HalcyonVector/TinySHM/docs/final_report/reference_folder/README.md

# Reference folder

These are the 15 references of the final report, in the same order and numbering as the paper.
All are from 2020 to 2026. Every DOI was checked against the publisher record (OpenAlex / publisher page) on 28 Oct 2026.

Publisher mix: IEEE 6, Elsevier 4, Springer 3, SAGE 2.

How to get the PDFs: open each DOI link on the college network (MAHE has IEEE Xplore, ScienceDirect and SpringerLink access) and save the PDF into this folder with the file name given below. Papers marked **Open access** can be downloaded from anywhere.

| # | File name to save as | Reference | Publisher | DOI link | Free copy |
|---|---|---|---|---|---|
| 1 | 01_Gharehbaghi2022.pdf | Gharehbaghi et al., "A critical review on structural health monitoring: Definitions, methods, and perspectives", Arch. Comput. Methods Eng., 29(4), 2209-2235, 2022 | Springer | https://doi.org/10.1007/s11831-021-09665-9 | Accepted version: https://research.usq.edu.au/item/q6x1w |
| 2 | 02_Hou2021.pdf | Hou and Xia, "Review on the new development of vibration-based damage identification for civil engineering structures: 2010-2019", J. Sound Vib., 491, 115741, 2021 | Elsevier | https://doi.org/10.1016/j.jsv.2020.115741 | College network |
| 3 | 03_Avci2021.pdf | Avci et al., "A review of vibration-based damage detection in civil structures: From traditional methods to ML and DL applications", Mech. Syst. Signal Process., 147, 107077, 2021 | Elsevier | https://doi.org/10.1016/j.ymssp.2020.107077 | College network |
| 4 | 04_Flah2021.pdf | Flah et al., "Machine learning algorithms in civil structural health monitoring: A systematic review", Arch. Comput. Methods Eng., 28(4), 2621-2643, 2021 | Springer | https://doi.org/10.1007/s11831-020-09471-9 | College network |
| 5 | 05_Bao2021.pdf | Bao and Li, "Machine learning paradigm for structural health monitoring", Struct. Health Monit., 20(4), 1353-1372, 2021 | SAGE | https://doi.org/10.1177/1475921720972416 | College network |
| 6 | 06_Malekloo2022.pdf | Malekloo et al., "Machine learning and structural health monitoring overview with emerging technology and high-dimensional data source highlights", Struct. Health Monit., 21(4), 1906-1955, 2022 | SAGE | https://doi.org/10.1177/14759217211036880 | College network |
| 7 | 07_Zonzini2020.pdf | Zonzini et al., "Structural health monitoring and prognostic of industrial plants and civil structures: A sensor to cloud architecture", IEEE Instrum. Meas. Mag., 23(9), 21-27, 2020 | IEEE | https://doi.org/10.1109/MIM.2020.9289069 | College network |
| 8 | 08_Ray2022.pdf | Ray, "A review on TinyML: State-of-the-art and prospects", J. King Saud Univ. Comput. Inf. Sci., 34(4), 1595-1623, 2022 | Elsevier | https://doi.org/10.1016/j.jksuci.2021.11.019 | **Open access** (Elsevier) |
| 9 | 09_Capogrosso2024.pdf | Capogrosso et al., "A machine learning-oriented survey on tiny machine learning", IEEE Access, 12, 23406-23426, 2024 | IEEE | https://doi.org/10.1109/ACCESS.2024.3365349 | **Open access**; also https://arxiv.org/abs/2309.11932 |
| 10 | 10_deSousa2023.pdf | de Sousa et al., "Multiclass supervised machine learning algorithms applied to damage and assessment using beam dynamic response", J. Vib. Eng. Technol., 11(6), 2709-2731, 2023 | Springer | https://doi.org/10.1007/s42417-023-01072-7 | Free copy: https://zenodo.org/records/11367651 |
| 11 | 11_Gong2022.pdf | Gong et al., "Review of research on loosening of threaded fasteners", Friction, 10(3), 335-359, 2022 | Springer (Tsinghua Univ. Press) | https://doi.org/10.1007/s40544-021-0497-1 | Open access |
| 12 | 12_Belega2021.pdf | Belega and Petri, "Unbiased sine-wave frequency estimation by parabolic interpolation of DTFT samples", IEEE I2MTC 2021, pp. 1-5 | IEEE | https://doi.org/10.1109/I2MTC50364.2021.9459910 | College network |
| 13 | 13_Burrello2022.pdf | Burrello et al., "Adversarially-trained tiny autoencoders for near-sensor continuous structural health monitoring", IEEE AICAS 2022, pp. 439-442 | IEEE | https://doi.org/10.1109/AICAS54282.2022.9869952 | College network |
| 14 | 14_Moallemi2023.pdf | Moallemi et al., "Speeding up system identification algorithms on a parallel RISC-V MCU for fast near-sensor vibration diagnostic", IEEE Sens. Lett., 7(9), 2023 | IEEE | https://doi.org/10.1109/LSENS.2023.3303074 | Accepted version: https://iris.unitn.it/retrieve/dd721f78-cd22-4842-99ca-2a3860a212da/nocolor_IEEE_Sensors_2023_SysId_GAP9_Rev1.pdf |
| 15 | 15_Capello2025.pdf | Capello et al., "Leveraging neural architecture search for structural health monitoring on resource-constrained devices", Lecture Notes in Electrical Engineering, pp. 323-330, 2025 | Springer | https://doi.org/10.1007/978-3-031-84100-2_38 | College network |

`references.bib` in this folder has the same 15 entries in BibTeX form for Zotero, Mendeley or Overleaf.

What each paper says and how it connects to our project is in `../VIVA_SHEET.md`.
