HalcyonVector/TinySHM/docs/final_report/Overleaf/paper.docx

Vibration-Based Structural Damage Detection Using an ARM Cortex-M3 Microcontroller

Sagnik Basu Reg. No. 240953528 Roll No. 42 | Pranav Gaddam Reg. No. 240953548 Roll No. 43 | Shobit Hegde Reg. No. 240953556 Roll No. 44

School of Computer Engineering

Section CCE A

Manipal Institute of Technology, Manipal, India

Abstract—Structural health monitoring (SHM) reveals damage before it leads to failure, but most vibration-based systems rely on costly acquisition hardware and a computer for analysis. The natural frequency, the most widely used damage indicator, is also blind to some faults and shifts under harmless changes such as added mass. Recent TinyML studies mostly target powerful processors, so a complete, verified pipeline on a basic microcontroller is missing. This paper presents a damage detection system that runs entirely on an LPC1768 ARM Cortex-M3. An MPU6050 MEMS accelerometer records the free vibration of a steel cantilever at 100 Hz. The firmware computes a windowed 1024-point FFT with parabolic peak interpolation and a log-envelope damping estimate, then runs a decision tree, k-nearest neighbours, a 5-8-4 neural network, a health score and a change detector, all trained offline and exported as C code. On 89 laboratory recordings covering a healthy state, added mass, loose joints and support loosening, the neural network reached 93.8% cross-validated accuracy against 84.2% for a frequency-only rule. The health score erred by 5.6 points on average, and board and PC outputs matched on every recording. Damping, not frequency, exposed support loosening. Explainable SHM therefore fits in 20 KB of flash on an entry-level microcontroller.

Index Terms—ARM Cortex-M3, edge machine learning, MEMS accelerometer, structural health monitoring, TinyML, vibration-based damage detection

I. Introduction

Civil and mechanical structures lose stiffness over time through cracks, corrosion and loosened connections. Structural health monitoring (SHM) aims to detect such damage automatically, ideally before it becomes visible, by answering four questions in order: is there damage, where is it, what type is it, and how severe is it [1]. Vibration-based methods are attractive because any change in stiffness, mass or boundary condition alters the dynamic response of the structure, which can be measured with a single accelerometer [2], [3].

The classical indicator is the first natural frequency. It is cheap to compute and global, but it has two known weaknesses. First, many faults barely change it, and second, harmless changes such as added mass or temperature shift it as much as real damage [2]. Machine learning (ML) addresses both by combining several features and learning the pattern of each condition from data [3], [4], [5]. However, most ML-based SHM pipelines are trained and run on a PC or in the cloud, which needs a continuous data link and dedicated acquisition hardware [6], [7].

Tiny machine learning (TinyML) moves inference onto the microcontroller next to the sensor [8], [9]. This reduces data traffic, power and cost, but most published SHM work at the edge uses multi-core or DSP-capable chips and neural networks that are hard to explain. This work asks a simpler question: can a complete, explainable damage detection pipeline, from raw acceleration to a named fault and a health score, run on an entry-level ARM Cortex-M3 with no floating-point unit and a 32 KB code limit, and can its results be verified on real hardware?

The contributions of this paper are:

1) An assemble-only cantilever test bench made from two steel rulers, binder clips and a screw clamp, on which three fault types are introduced repeatably and without tools.

2) Fixed-point-friendly firmware for the LPC1768 that samples an MPU6050 at 100 Hz and extracts five features, including interpolated frequency and log-envelope damping, with a self-written radix-2 FFT.

3) Six lightweight models (decision tree, kNN, 5-8-4 neural network, kNN health regression, z-score change detector and novelty detector) trained on a laptop and exported automatically as C code.

4) An experimental study on 89 recordings showing that the ML outperforms a frequency-only rule, that damping is the only usable indicator of support loosening, and that board and PC outputs are identical.

II. Literature Review

A. Vibration-based damage identification

Hou and Xia [2] reviewed a decade of vibration-based damage identification for civil structures. They group methods by the feature used, such as natural frequencies, mode shapes, damping and frequency response functions, and note that frequency is the easiest to measure but the least informative about the type and location of damage. Gharehbaghi et al. [1] formalise the SHM levels and compare model-based and data-driven approaches. Both reviews stress that environmental and operational changes can mask or mimic damage, which motivates the added-mass test used in this work.

B. Machine learning for SHM

Avci et al. [3] trace the move from hand-set thresholds to ML and deep learning, showing that a feature-extraction stage followed by a classifier is the dominant structure. Flah et al. [4] systematically review supervised and unsupervised algorithms in civil SHM and identify small labelled datasets as the main obstacle. Bao and Li [5] describe ML as a new paradigm for SHM covering damage identification, data anomaly detection and condition assessment. Malekloo et al. [6] survey ML together with emerging sensing technology, including low-cost MEMS sensors and IoT nodes. Closest to this work, de Sousa et al. [10] compared kNN, support vector machines, decision trees, random forests and naive Bayes for classifying damage in cantilever beams. Using natural-frequency indices alone their accuracy ranged from about 59% to 94%, while richer response features reached about 95% on experimental data, showing that frequency alone is not enough.

C. Loosening as a fault

Loosened supports and bolted joints are among the most common faults in real structures. Huang et al. [11] review loosening detection for threaded fasteners and report that vibration-based methods detect it through changes in stiffness and in energy dissipation at the contact interface, that is, through both frequency and damping. This motivates the damping feature used here.

D. Frequency estimation

With a finite record, the FFT resolves frequency only to Δf=F_s /N . Belega and Petri [12] show that fitting a parabola through the three largest DTFT samples around a peak estimates the frequency far more accurately than the peak bin alone, at almost no extra cost. This technique is used on the board.

E. SHM at the edge and TinyML

Zonzini et al. [7] propose a sensor-to-cloud SHM architecture in which MEMS sensor nodes pre-process data before sending it. Ray [8] and Capogrosso et al. [9] review TinyML frameworks, model compression and deployment on microcontrollers. In SHM specifically, Burrello et al. [13] train tiny autoencoders to detect anomalies near the sensor, Moallemi et al. [14] accelerate output-only system identification on a parallel RISC-V microcontroller, and Capello et al. [15] use neural architecture search to fit SHM models on resource-constrained devices.

F. Research gap

Table I summarises the closest works. Existing edge SHM studies use capable processors and anomaly-only or black-box models, while the beam classification studies run on a PC. None of them combines fault-type classification, a severity score and a change detector on a basic Cortex-M3, verified against real data with identical outputs from the PC and the board.

TABLE I

Comparison with closely related work

Work | Platform | Output | Features | Data
[10] | PC | fault class | freq., FRF | sim. + exp.
[13] | MCU (multi-core) | anomaly | raw signal | real
[14] | RISC-V MCU | modal param. | AR/ARMA | real
[15] | MCU | anomaly | learned | real
This work | Cortex-M3 | class, health, | freq., damping, | real
| (no FPU) | change, novelty | 3 more | (89 flicks)

III. Methodology

A. Overall approach

Fig. 1 shows the method. Labelled flicks are recorded on the board and logged to a laptop over UART. The laptop extracts the same five features as the board, trains and cross-validates the models, and exports them to a C header (model.h). The header is compiled into the firmware, after which the board classifies every new flick on its own. A parity check runs the C code on the PC and compares it with Python for every recording.

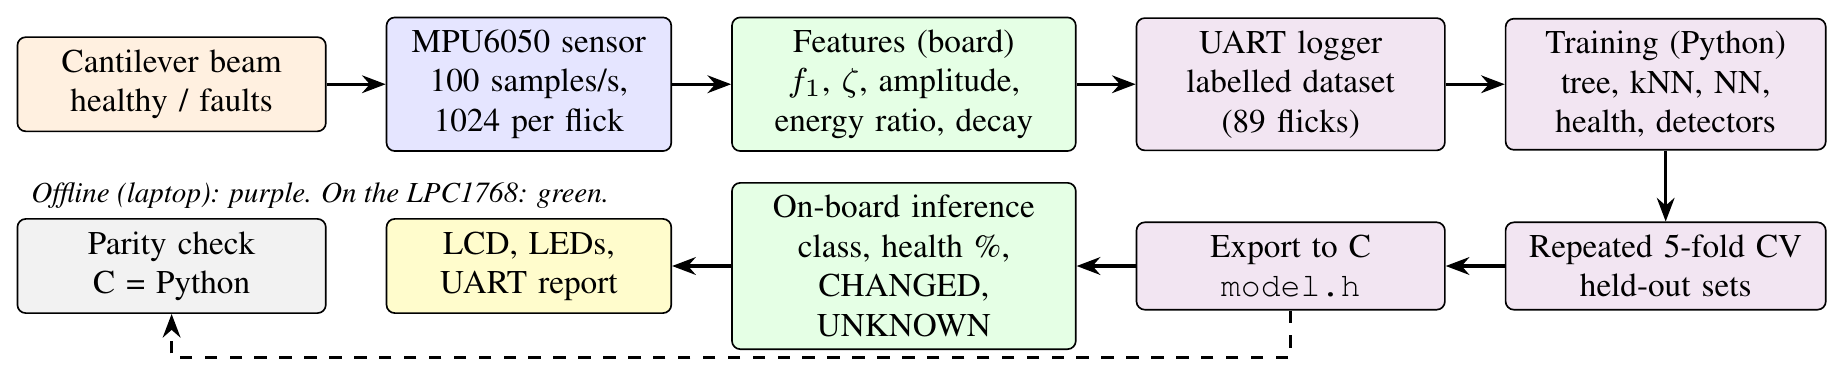
[picture p16: figure]

Fig. 1. Method approach: data collection, offline training and on-board deployment.

B. Test structure and fault cases

The structure is a cantilever made of two 30 cm steel rulers (Fig. 2). Ruler A projects 18.5 cm beyond the table edge and is held by a 10-inch screw G-clamp over a cardboard pad. Ruler B overlaps A by 13.5 cm and is joined to it by three binder clips, giving a free length of about 35.5 cm. The MPU6050 module is taped near the tip. Each measurement starts with a manual flick of the tip, after which the beam rings freely. The build needs no drilling or cutting, so the bench can be reassembled in any lab.

Three fault types were introduced (Fig. 3). Added mass: a Rs 20 and a Rs 5 coin taped together at the 28–30 cm mark. This is a change but not damage. Loose joint: the middle binder clip removed (level 1), then one end clip removed as well (level 2). Loose support: the G-clamp screw loosened in three steps of about 1/4, 1/2 and 3/4 turn; 3/4 turn is the loosest setting at which the beam still stays in place.


Fig. 2. Experimental setup. Left: LPC1768 board, power supply and the clamped two-ruler cantilever with the MPU6050 near the tip. Right: side view showing the three binder clips, the G-clamp and the wiring to the board.


Fig. 3. Fault cases. Left: added mass, coins taped beyond the sensor. Right: loose joint, clips removed from the ruler overlap.

C. Hardware

Fig. 4 shows the block diagram. The LPC1768 (ARM Cortex-M3, 100 MHz, 512 KB flash, 64 KB SRAM) sits on the ALS-SDA-ARMCTXM3-01 development board. The MPU6050 is read over a software I²C bus on two GPIO pins, with its measuring range set to ±4 g, so it can read accelerations up to four times gravity in either direction, and its internal low-pass filter set to 44 Hz to prevent aliasing. Timer 0 triggers a reading every 10 ms. The board's 16 × 2 LCD shows the result, eight LEDs form a health bar, and the 4 × 4 keypad selects calibration, teach mode and display pages. UART0 at 19200 baud sends every result and, while logging, the raw samples to the laptop.


Fig. 4. Block diagram of the hardware.


Fig. 5. LPC1768 board during a fault test. The LCD shows the change alarm and the health score.

D. Signal processing and features

A flick is detected when the acceleration departs from its resting value by more than 0.3 g. The next N=1024 samples at F_s =100 Hz (10.24 s) are stored. The physical basis of the method is the single-degree-of-freedom model of the beam's first mode,

f=1/(2π)√(k/m), (1)

so a loss of stiffness k or a gain in mass m lowers the natural frequency [2]. After removing the mean, the record is multiplied by a Hann window to reduce spectral leakage,

w[n]=0.5−0.5cos((2πn)/(N−1)), (2)

and transformed with a radix-2 FFT,

X[k]=∑_(n=0)^(N−1) x[n] w[n] e^(−j2πkn/N) . (3)

The bin width is Δf=F_s /N=0.098 Hz, and the largest bin k_p between 3 and 40 Hz is refined with parabolic interpolation through its magnitude β and its neighbours α and γ [12]:

δ=1/2 (α−γ)/(α−2β+γ),  f_1 =(k_p +δ) Δf. (4)

Damping is taken from the free decay. For a lightly damped mode the amplitude decays as A(t)=A_0 e^(−ζω_1 t) with ω_1 =2πf_1 . Taking logarithms gives a straight line, so the damping ratio is

ζ=−s/(2πf_1), (5)

where s is the least-squares slope of ln RMS against time, computed over 0.25 s windows from the loudest window until the RMS falls below 5% of its peak. Three further features are the peak amplitude a_(max) (flick strength), the energy ratio

E_r =(∑_(k∈B)^() |X[k]|^2 −∑_(|k−k_p |≤h)^() |X[k]|^2)/(∑_(k∈B)^() |X[k]|^2), (6)

which measures energy outside ±1 Hz of the main peak (rattle and harmonics) within the band B of 3–40 Hz, and the decay time t_d until the RMS drops below 10% of its peak. The feature vector is x=[f_1 ,ζ,a_(max) ,E_r ,t_d ] .

E. Models

All models use the standardised features x_i =(x_i −μ_i )/σ_i .

Frequency-only baseline: a depth-2 tree on f_1 , representing the classical frequency-shift rule.

Decision tree: CART of depth 3 with Gini impurity G=1−∑_c^() p_c^2 ; it is exported as nested if statements.

k-nearest neighbours: k=3 with Euclidean distance over the 68 stored training flicks; new examples can be added on the board in teach mode.

Neural network: a 5-8-4 multilayer perceptron,

h=max(0,W_1 x+b_1 ), p=softmax(W_2 h+b_2 ), (7)

with 84 parameters; the largest p_c is the predicted class and its value the confidence.

Health score: each training condition has a damage level d∈[0,1] (healthy 0, added mass 0, loose joint 0.5 and 1.0, loose support up to 0.75). The health of a new flick is

H=100(1−1/3∑_(j=1)^3 d_j ), (8)

where d_j are the levels of its three nearest neighbours. H<40 is reported as UNSAFE.

Change detector: the distance from the healthy baseline,

z=√(1/5∑_(i=1)^5 ((x_i −μ_i^h)/(σ_i^h))^2), (9)

flags CHANGED when z>3 . The baseline μ^h ,σ^h can be recalibrated on the board from ten healthy flicks (key C). Novelty detector: UNKNOWN is shown when the nearest stored flick is farther than twice the 95th percentile of nearest-neighbour distances in the training set.

Trend: the health of successive inspections is fitted with a line H=a+b t , and the step at which H reaches 40 is predicted as (40−a)/b .

F. Firmware flow

Fig. 6 shows the firmware loop. All models are compiled from the exported header, so no training happens on the board.


Fig. 6. Flowchart of the on-board firmware.

G. Data collection and evaluation

Each flick is labelled on the laptop and logged with its raw samples. Table II lists the dataset. Before each fault the beam geometry was checked against a healthy reference; 24 flicks recorded with an incorrect ruler overlap of 15 cm were discarded. The first two support-loosening steps were kept out of training because their features lay inside the healthy spread (Section IV-C); they are used only as a held-out test, together with five healthy re-check flicks. Accuracy is the mean of 5-fold stratified cross-validation repeated five times on the 68 training flicks.

TABLE II

Recorded dataset (medians)

Condition | Flicks | f_1 (Hz) | ζ (%) | Use
Healthy | 30 | 4.74 | 2.92 | train
Added mass | 12 | 3.68 | 2.58 | train
Loose joint 1 | 10 | 4.47 | 2.67 | train
Loose joint 2 | 8 | 4.45 | 1.16 | train
Loose support 3/4 turn | 8 | 4.75 | 3.45 | train
Loose support 1/4 turn | 8 | 4.71 | 3.26 | held out
Loose support 1/2 turn | 8 | 4.75 | 3.13 | held out
Healthy re-check | 5 | 4.68 | 2.95 | held out
Total | 89

IV. Results and Discussion

A. Frequency estimation on the board

Table III compares three frequency estimators against a 16 × zero-padded FFT reference over all 89 flicks, with execution times measured on the LPC1768 using SysTick. Parabolic interpolation reduced the mean error from 0.027 Hz to 0.009 Hz, less than a tenth of the bin width, at no measurable extra time. Zero-crossing counting is 28 times faster but its mean error of 0.34 Hz is larger than the 0.27 Hz shift caused by a loose joint, so it cannot separate the classes (Fig. 7). The FFT takes 117 ms, which is negligible against the 10.24 s recording.

TABLE III

Frequency estimators measured on the LPC1768

Method | Mean err. | Max err. | Time | RAM
FFT peak bin | 0.027 Hz | 0.052 Hz | 116.9 ms | 8 KB
Interpolated FFT, (4) | 0.009 Hz | 0.063 Hz | 116.9 ms | 8 KB
Zero-crossing | 0.338 Hz | 2.07 Hz | 4.2 ms | none


Fig. 7. Error and execution time of the three frequency estimators.

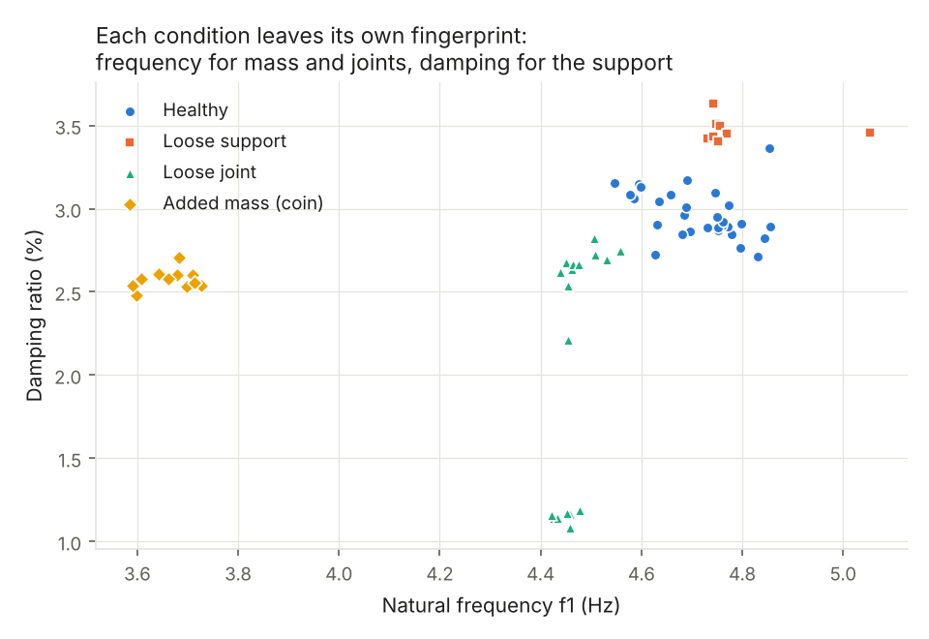
[picture p17: figure]

Fig. 8. Damping against first natural frequency for all training flicks.

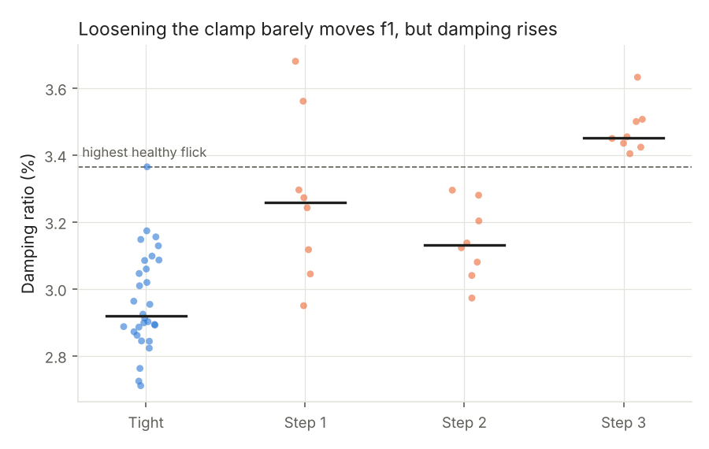
[picture p18: figure]

Fig. 9. Damping ratio at each support-loosening step compared with the healthy range.

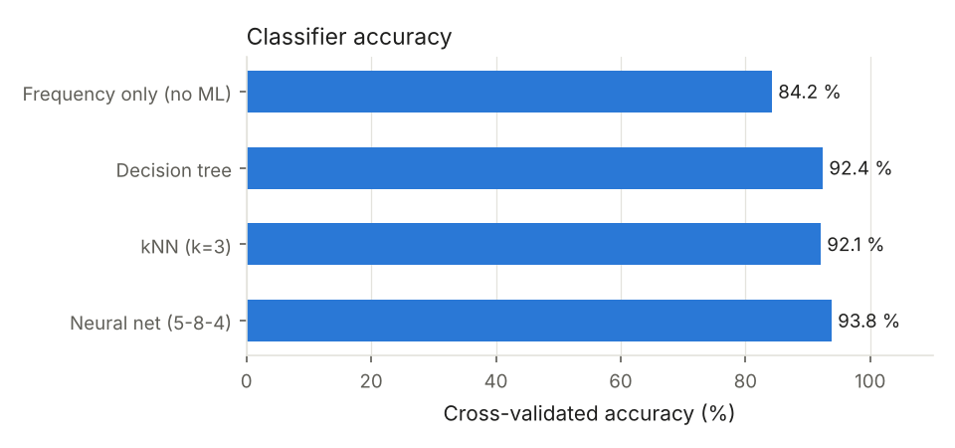
[picture p19: figure]

Fig. 10. Accuracy of the frequency-only rule and the three classifiers.

B. Each fault has its own signature

Fig. 8 plots damping against frequency for every flick. The added mass lowers f_1 by 22%, as (1) predicts for an increase in m . Removing clips lowers f_1 by about 6% through a loss of joint stiffness, and removing the second clip also lowers damping from 2.9% to 1.2%, because less friction remains at the overlap. Loosening the support does not change f_1 at all (4.75 Hz against 4.74 Hz) but raises damping, since the loosely held end dissipates energy through friction, consistent with the loosening literature [11]. A frequency-only method therefore cannot see this fault.

C. Detection limit for support loosening

Fig. 9 shows damping at each loosening step. At 1/4 and 1/2 turn the damping lies inside the healthy spread, while at 3/4 turn every flick is above the highest healthy flick, with a median increase of 18%. The screw clamp keeps gripping the ruler until it is almost released, so the first two steps are below the detection limit of this setup. On these held-out flicks the neural network labelled 4 of 8 and 3 of 8 as loose support, and the change detector fired once, which is consistent with features that sit on the boundary of the healthy cluster.

D. Classification accuracy

Table IV and Fig. 10 give the cross-validated accuracy. All three ML models beat the frequency-only rule by 8 to 10 percentage points. The decision tree uses f_1 for 71% of its splits and damping for 27%, confirming that the gain comes from the damping feature. The confusion matrices in Fig. 11 show that most remaining errors are between healthy and loose support, the hardest pair. All five healthy re-check flicks were classified as healthy with no CHANGED alarm.

TABLE IV

Cross-validated classification accuracy (4 classes)

Model | Accuracy
Frequency only (depth-2 tree on f_1 ) | 84.2%
Decision tree, depth 3 | 92.4%
kNN, k=3 | 92.1%
Neural network 5-8-4 | 93.8%

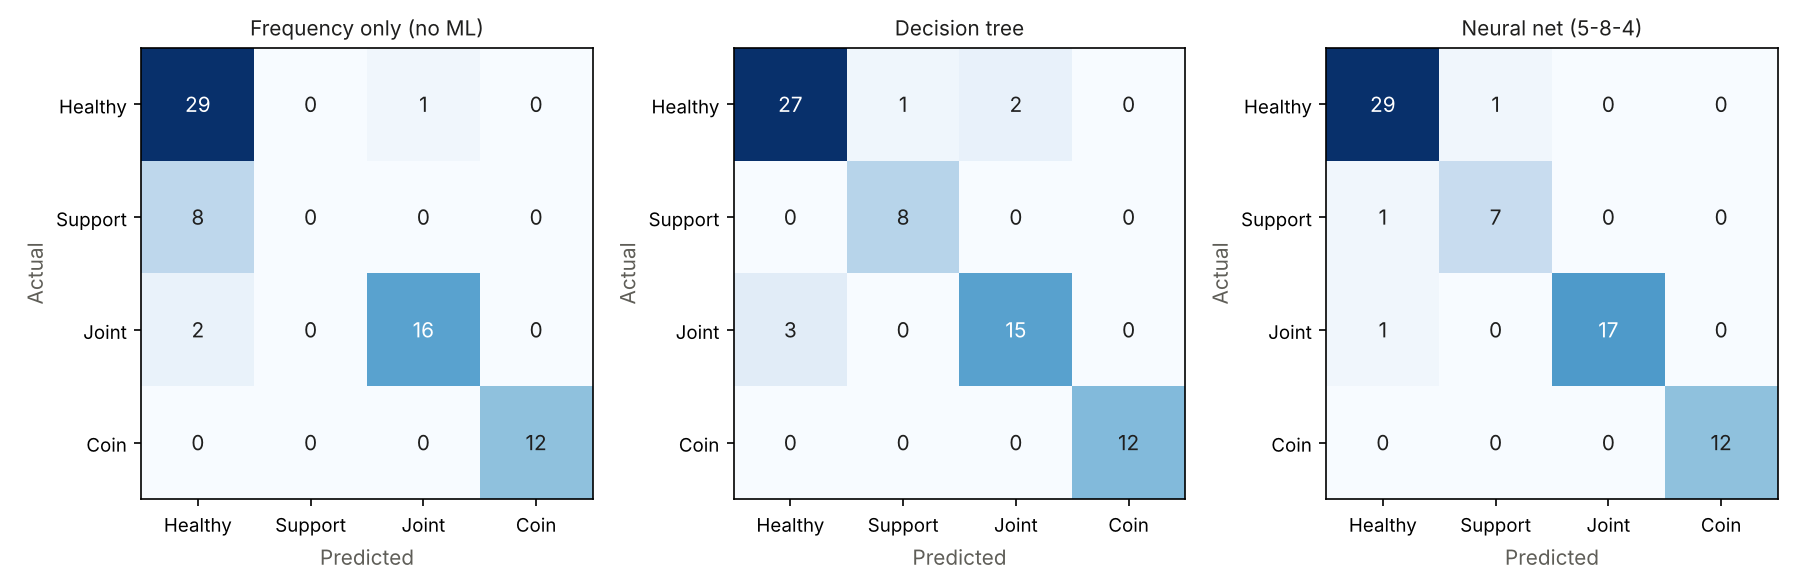
[picture p20: figure]

Fig. 11. Confusion matrices from cross-validation (left to right: frequency only, decision tree, neural network).

E. Health score and trend

The kNN health score had a mean absolute error of 5.6 points, against 17.8 points for linear regression on the same features (Fig. 12). In leave-one-out tests, healthy flicks scored 95.8 on average and none fell below the unsafe threshold. Over the support-loosening steps the mean health was 97, 66, 69 and 33. A line fitted to steps 0 to 2 predicted the beam would become unsafe at step 3.6; in the experiment it was unsafe at step 3, so the forecast was slightly late but in the right range (Fig. 12, right).

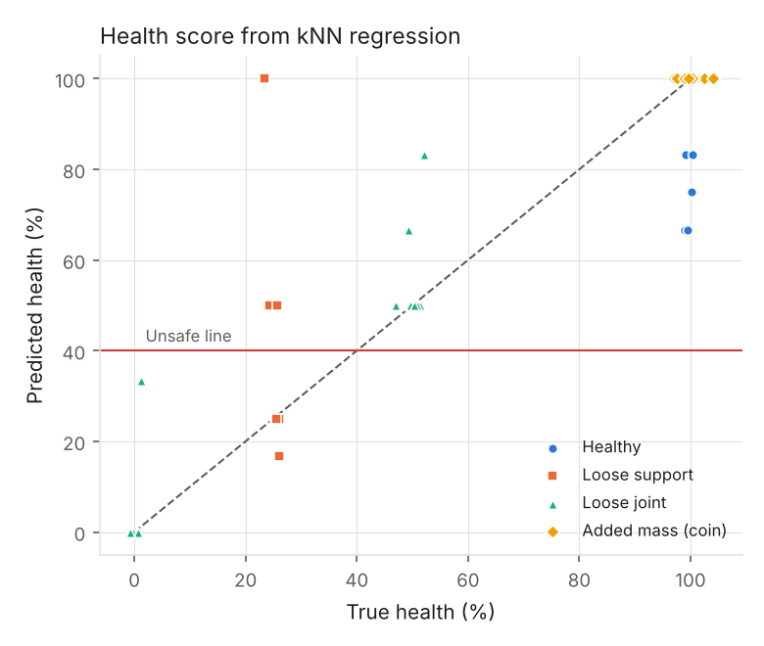
[picture p21: figure]

Fig. 12. Left: predicted against true health score. Right: health over successive loosening steps and the predicted unsafe point.

F. On-board operation and reporting

The complete firmware, including the FFT, all six models and the training data needed by kNN, occupies about 20 KB of flash, within the 32 KB limit of the free Keil toolchain, and the FFT buffers use 8 KB of RAM. The C implementation was run on all 89 flicks on the PC and produced the same features and decisions as the Python reference for every flick. Fig. 5 shows the board reporting a detected change and an unsafe health value during a fault test.

Finally, the laptop transmits the results for each condition (median frequency, damping, health status, predicted class, confidence, cross-validated accuracies and trend prediction) to a large language model (gpt-oss-120b using the Groq API and using Gemini as a fallback). The language model is then prompted to produce a brief inspection summary in simple English. The language model does not make any decisions; all numbers come directly from the measured table, and all detection and classification is performed by the models on the board. In our case, the report correctly identified loose joint 2 and the 3/4 turn support as being unsafe, and identified the added mass as being harmless. However, the confidence of the classifier was exaggerated for the first two steps of loosening. Therefore, the report should always be checked against the table.

G. Contributions verified through results

Each claimed contribution is backed by a measured result. The assemble-only bench produced repeatable conditions: the healthy re-check after all faults gave 4.68 Hz against the original 4.74 Hz, and all five re-check flicks were classified healthy. The interpolated FFT on the Cortex-M3 measured frequency to within 0.009 Hz on average, ten times finer than the 0.098 Hz bin, in 117 ms. Adding damping and three other features raised four-class accuracy from 84.2% for the classical frequency rule to 93.8% with the neural network, and damping alone exposed support loosening, which left frequency unchanged and increased damping by 18%. The kNN health score tracked damage severity with a mean error of 5.6 points and kept every healthy flick above the unsafe limit, and its trend forecast placed the unsafe point within one step of the observed one. Finally, the exported C models reproduced the Python features and decisions on all 89 flicks while using about 20 KB of flash. The experiment also set an honest limit: support loosening below about 3/4 turn could not be distinguished from the healthy state with this sensor and structure.

H. Limitations

The dataset is small (89 flicks) and comes from one structure in one room, so temperature and long-term drift were not studied. Flicks were applied by hand, which varies the amplitude; the amplitude feature absorbs this, but a mechanical exciter would give cleaner data. Only the first mode was used.

V. Conclusion

This paper showed that a complete vibration-based damage detection pipeline, from raw acceleration to a fault name, a health score and a trend forecast, can run on an entry-level ARM Cortex-M3 with a low-cost MEMS accelerometer. On a tool-free cantilever bench the system separated healthy, added-mass, loose-joint and loose-support conditions with 93.8% accuracy, compared with 84.2% for the classical frequency-shift rule, and the health score had a mean error of 5.6 points. The key finding is that damping, which the frequency rule ignores, is the only usable indicator of support loosening. All models fit in about 20 KB of flash and agree exactly with their PC reference. Future work will add a mechanical exciter, temperature compensation, higher modes from a second sensor and a larger multi-day dataset to lower the detection limit for early loosening.

Acknowledgment

The authors thank their guides, Dr. G Pradeep Reddy and Pragya Jha, Assistant Professors, School of Computer Engineering, Manipal Institute of Technology, for their guidance, and the Embedded Systems Laboratory for the LPC1768 boards.

References

[1] V. R. Gharehbaghi, E. Noroozinejad Farsangi, M. Noori, T. Y. Yang, S. Li, A. Nguyen, C. Málaga-Chuquitaype, P. Gardoni and S. Mirjalili, “A critical review on structural health monitoring: Definitions, methods, and perspectives,” Archives of Computational Methods in Engineering, vol. 29, no. 4, pp. 2209–2235, 2022, doi: 10.1007/s11831-021-09665-9.

[2] R. Hou and Y. Xia, “Review on the new development of vibration-based damage identification for civil engineering structures: 2010–2019,” Journal of Sound and Vibration, vol. 491, Art. no. 115741, 2021, doi: 10.1016/j.jsv.2020.115741.

[3] O. Avci, O. Abdeljaber, S. Kiranyaz, M. Hussein, M. Gabbouj and D. J. Inman, “A review of vibration-based damage detection in civil structures: From traditional methods to machine learning and deep learning applications,” Mechanical Systems and Signal Processing, vol. 147, Art. no. 107077, 2021, doi: 10.1016/j.ymssp.2020.107077.

[4] M. Flah, I. Nunez, W. Ben Chaabene and M. L. Nehdi, “Machine learning algorithms in civil structural health monitoring: A systematic review,” Archives of Computational Methods in Engineering, vol. 28, no. 4, pp. 2621–2643, 2021, doi: 10.1007/s11831-020-09471-9.

[5] Y. Bao and H. Li, “Machine learning paradigm for structural health monitoring,” Structural Health Monitoring, vol. 20, no. 4, pp. 1353–1372, 2021, doi: 10.1177/1475921720972416.

[6] A. Malekloo, E. Ozer, M. AlHamaydeh and M. Girolami, “Machine learning and structural health monitoring overview with emerging technology and high-dimensional data source highlights,” Structural Health Monitoring, vol. 21, no. 4, pp. 1906–1955, 2022, doi: 10.1177/14759217211036880.

[7] F. Zonzini, C. Aguzzi, L. Gigli, L. Sciullo, N. Testoni, L. De Marchi, M. Di Felice, T. S. Cinotti, C. Mennuti and A. Marzani, “Structural health monitoring and prognostic of industrial plants and civil structures: A sensor to cloud architecture,” IEEE Instrumentation & Measurement Magazine, vol. 23, no. 9, pp. 21–27, 2020, doi: 10.1109/MIM.2020.9289069.

[8] P. P. Ray, “A review on TinyML: State-of-the-art and prospects,” Journal of King Saud University - Computer and Information Sciences, vol. 34, no. 4, pp. 1595–1623, 2022, doi: 10.1016/j.jksuci.2021.11.019.

[9] L. Capogrosso, F. Cunico, D. S. Cheng, F. Fummi and M. Cristani, “A machine learning-oriented survey on tiny machine learning,” IEEE Access, vol. 12, pp. 23406–23426, 2024, doi: 10.1109/ACCESS.2024.3365349.

[10] A. A. S. R. de Sousa, J. S. Coelho, M. R. Machado and M. Dutkiewicz, “Multiclass supervised machine learning algorithms applied to damage and assessment using beam dynamic response,” Journal of Vibration Engineering & Technologies, vol. 11, no. 6, pp. 2709–2731, 2023, doi: 10.1007/s42417-023-01072-7.

[11] J. Huang, J. Liu, H. Gong and X. Deng, “A comprehensive review of loosening detection methods for threaded fasteners,” Mechanical Systems and Signal Processing, vol. 168, Art. no. 108652, 2022, doi: 10.1016/j.ymssp.2021.108652.

[12] D. Belega and D. Petri, “Unbiased sine-wave frequency estimation by parabolic interpolation of DTFT samples,” in Proc. IEEE Int. Instrumentation and Measurement Technology Conf. (I2MTC), 2021, pp. 1–5, doi: 10.1109/I2MTC50364.2021.9459910.

[13] A. Burrello, G. Sintoni, D. Brunelli and L. Benini, “Adversarially-trained tiny autoencoders for near-sensor continuous structural health monitoring,” in Proc. IEEE 4th Int. Conf. Artificial Intelligence Circuits and Systems (AICAS), 2022, pp. 439–442, doi: 10.1109/AICAS54282.2022.9869952.

[14] A. Moallemi, R. Gaspari, F. Zonzini, L. De Marchi, D. Brunelli and L. Benini, “Speeding up system identification algorithms on a parallel RISC-V MCU for fast near-sensor vibration diagnostic,” IEEE Sensors Letters, vol. 7, no. 9, pp. 1–4, 2023, doi: 10.1109/LSENS.2023.3303074.

[15] A. Capello, R. Berta, M. Fresta, L. Lazzaroni and F. Bellotti, “Leveraging neural architecture search for structural health monitoring on resource-constrained devices,” in Applications in Electronics Pervading Industry, Environment and Society, Lecture Notes in Electrical Engineering. Cham, Switzerland: Springer, 2025, pp. 323–330, doi: 10.1007/978-3-031-84100-2_38.
