HalcyonVector/TinySHM/docs/final_report/figs/photo_coin_close.jpg

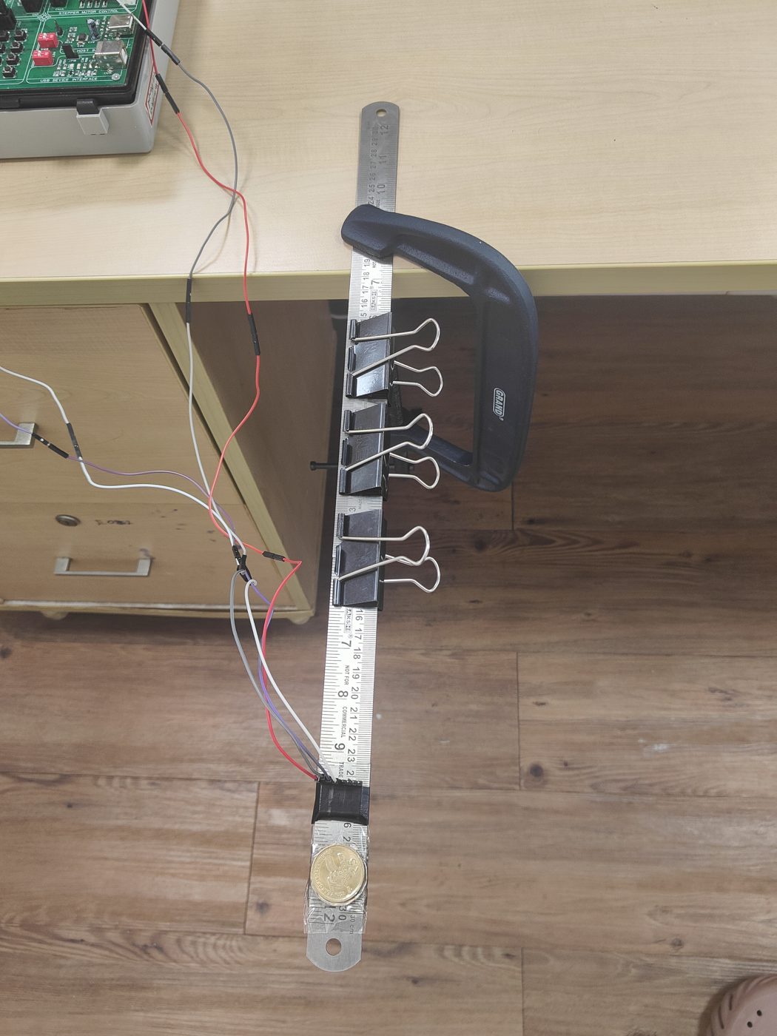
docs/final_report/figs/photo_coin_close.jpg
