HalcyonVector/TinySHM/docs/final_report/figs/photo_joint_removed.jpg

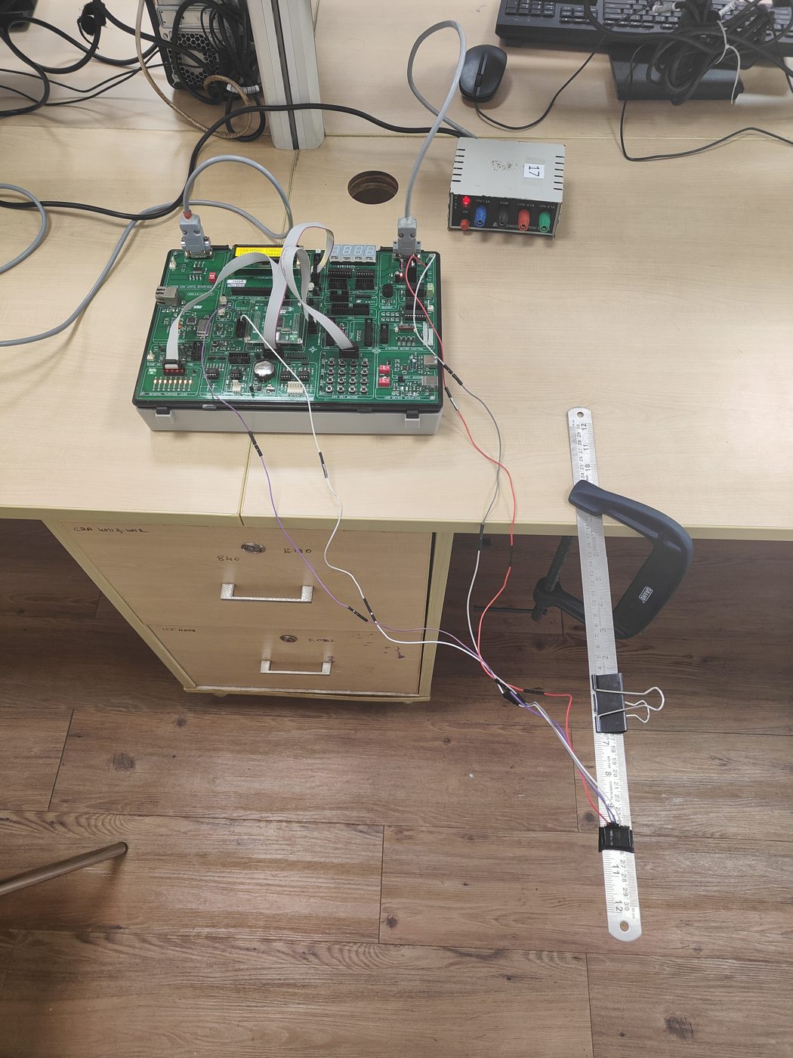
docs/final_report/figs/photo_joint_removed.jpg
