HalcyonVector/TinySHM/docs/SHOPPING_LIST.md

# TinySHM parts list

No drilling, cutting or soldering. Everything is held down, clipped or taped by hand.
Prices are approximate and include GST.

## 1. Sensor

| Item | Qty | Approx. price | Notes |
|---|---|---|---|
| MPU6050 module (GY-521), header pins already soldered | 2 (1 + 1 spare) | ₹150 to ₹250 each | Digital (I2C), 16-bit, built-in filter |

## 2. Wires

| Item | Qty | Approx. price | Used for |
|---|---|---|---|
| Female-to-female jumper wires, 20 cm | 1 pack of 40 | ₹60 to ₹70 | Sensor to board: 4 wires, plus spares |
| Crocodile-clip test leads | 1 pack of 10 | ₹60 to ₹100 | Backup only: in case a jumper won't stay on the TP2 (3.3 V) and TP3 (GND) posts |

## 3. Beam and mounting

| Item | Qty | Approx. price | Used for |
|---|---|---|---|
| 30 cm steel ruler, all the same brand | 3 | ₹120 (₹40 each) | Two make the beam, one spare |
| Screw C-clamp (G-clamp), 3 or 4 inch | 1 | ₹150 to ₹250 | Clamps ruler A to the table edge by hand: turn the T-handle, no nails or tools, no marks on the table. Ask a hardware shop for a "G clamp" or "C clamp with screw". A screw F-clamp (bar clamp, about ₹250 to ₹400) works the same. Avoid trigger-type quick-grip clamps: they can't be loosened by a quarter turn for the loose-support test. Books are only the last resort |
| Binder clips, 25 mm or 32 mm | 1 small pack (6 or more) | ₹40 | Join the two rulers (3 clips), spares |
| Thin double-sided tape (not foam tape) | 1 roll | ₹40 | Sticks the sensor to the ruler |
| Insulation tape | 1 roll | ₹20 | Holds the sensor firmly, tapes the wires along the ruler |

## 4. From the lab (nothing to buy)

- LPC1768 board (ALS-SDA-ARMCTXM3-01), power cable and DB9 cable
- FRC cables for the LCD (CND to CNAD), keypad (CNB to CNB3) and LEDs (CNA to CNA1)
- PC with Keil uVision 4 and Flash Magic
- A coin (for the added-mass test) and a pen or tape (to mark where the ruler and clamp go)

## Total

| | Approx. amount |
|---|---|
| Sensor (with spare) | ₹300 to ₹500 |
| Wires | ₹120 to ₹170 |
| Beam and mounting | ₹370 to ₹470 |
| **Total** | **about ₹790 to ₹1,140** |
