HalcyonVector/TinySHM/docs/final_report/figs/photo_setup_coin.jpg

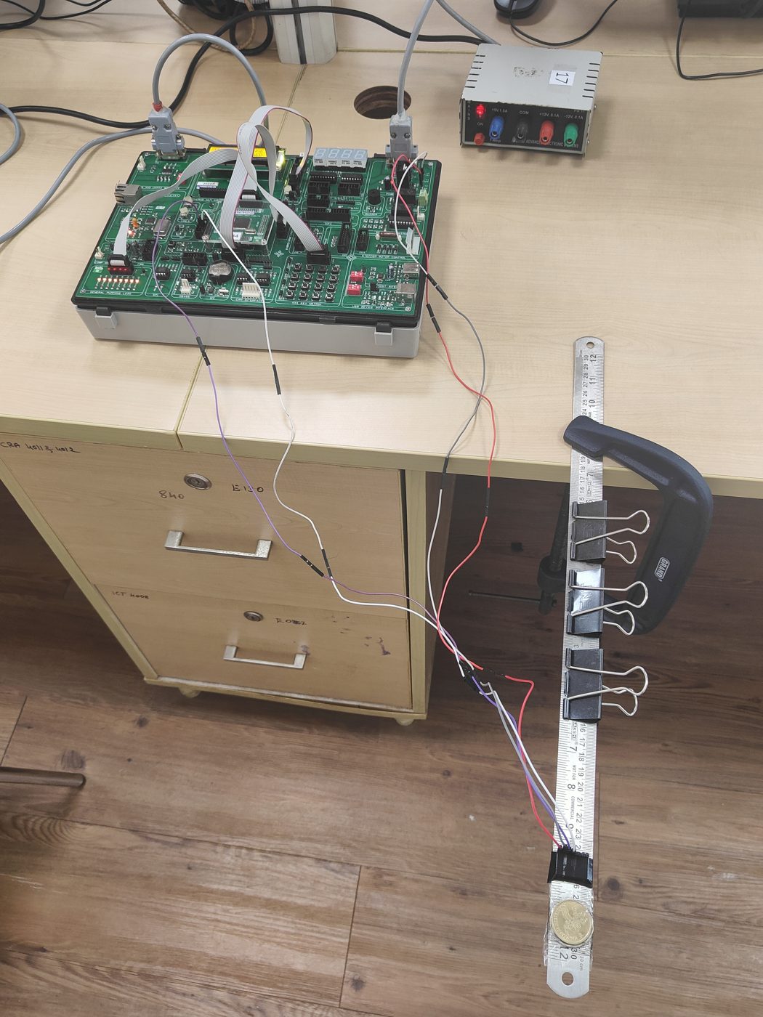
docs/final_report/figs/photo_setup_coin.jpg
