HalcyonVector/TinySHM/docs/final_report/figs/photo_setup_top.jpg

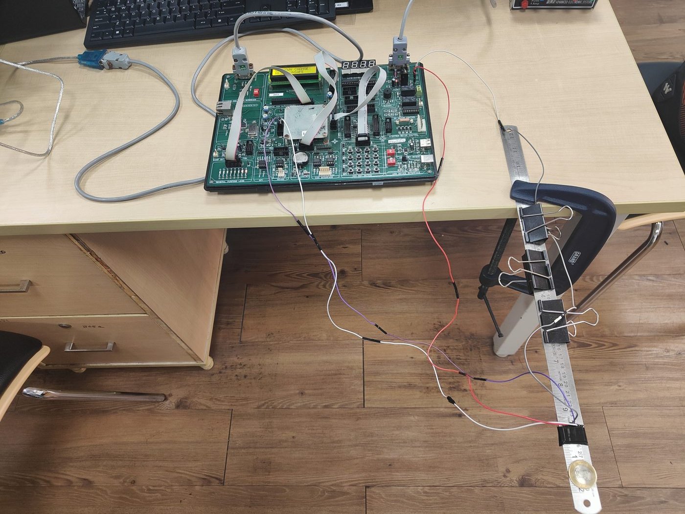
docs/final_report/figs/photo_setup_top.jpg
