HalcyonVector/TinySHM/(commit log)

2026-10-11 Initial commit: board firmware, laptop ML pipeline and simulator
2026-10-17 Add MPU6050 (I2C1) sensor support with switch back to ADXL335
2026-10-17 Add step-by-step build and wiring guide
2026-10-17 Build guide: compare ADXL335 and MPU6050, wiring for both
2026-10-17 Build guide: drawn beam and wiring diagrams, fix beam lengths to fit 30 cm rulers
    [check_c_parity.py, simulate.py]
2026-10-17 Build guide: board photo with power, ground and JP18 locations
2026-10-17 Build guide: CNC location confirmed on the lab board
2026-10-17 Build guide: board photo table, no-FRC sensor wiring, updated wiring diagram
2026-10-21 Add frequency method comparison (objective 5) and LED health bar/alarm
    Board times FFT peak, interpolated FFT and zero-crossing with SysTick and
    sends a BENCH line per flick; pc/compare_methods.py compares accuracy, RAM
    and board timing. LEDs on CNA show a health bar and flash for UNSAFE and
    UNKNOWN. Docs note the 2 KB stack setting.
2026-10-22 MPU6050 only; hold the beam with books instead of a C-clamp
    Remove the ADXL335 code paths and docs. Rename the loose_clamp fault to
    loose_support (take books off one at a time), regenerate the simulated
    data, models and plots, and redraw the beam, wiring and board diagrams.
    [config.h, config.py, features.py, hw.c, hw.h, llm_report.py, logger.py, main.c]
2026-10-22 Show the C-clamp in the beam diagram again
2026-10-22 Keep the C-clamp as the plan, with books as a fallback
2026-10-22 Fix Windows UnicodeEncodeError when saving the LLM report
    Write and read text files as UTF-8, swap fancy dashes and quotes for plain
    ones, and print the report safely on the Windows console.
    [build_dataset.py, compare_methods.py, export_c.py, llm_report.py, logger.py, predict.py, train.py, trend.py]
2026-10-22 Comment fix in simulate.py
    [simulate.py]
2026-10-23 Show sensor wiring diagnostic on LCD and try address 0x69
2026-10-23 Retry the MPU6050 check at startup, free a stuck I2C bus, and fall back to the step-by-step read
    [hw.c]
2026-10-23 Talk to the MPU6050 with software I2C and list every chip on the bus when it is not found
2026-10-23 Try both software I2C and the I2C1 peripheral, and test that the board can pull each line low
2026-10-23 Try the I2C1 peripheral first on untouched pins, accept any WHO_AM_I answer, and show first and last attempt
2026-10-25 Find the MPU6050 on CNC or CNA (I2C2), show a live reading at start-up, add lab day checklist
2026-10-25 logger.py --file imports a saved terminal capture; lab checklist covers the LED cable and getting data off the lab PC
2026-10-26 When the sensor is not found, check with pull-downs whether SDA/SCL on CNC reach the module
2026-10-26 Add a live wire-tester hex for the sensor pins on CNC and CNA
2026-10-26 Add a live test hex: CNC wire check plus a slow WHO_AM_I ping
2026-10-26 Talk to the sensor with slow software I2C and internal pull-ups only; the peripheral at 100 kHz failed on the long jumper wires
    [config.h, hw.c]
2026-10-27 Docs: say clearly the clamp is a hand-tightened screw G-clamp (no nails), F-clamp as the alternative, pad to protect the table
2026-10-27 Build guide: a big G-clamp is fine; only ruler A is clamped
2026-10-27 Build guide: fit the G-clamp with the T-handle on top
2026-10-27 Build guide: fit the G-clamp diagonally so its frame doesn't block the beam
2026-10-27 logger: retry opening the port with default settings when a CH340 driver rejects DTR/RTS
2026-10-27 UART at 19200 baud: the CH340 cable on the laptop refuses 38400 and above
2026-10-27 Add ready-to-flash hex files (detector at 19200 baud, live test, wire test)
2026-10-27 Healthy flicks
    [real_log.csv]
2026-10-27 logger: last-resort port setup with Windows mode when the CH340 driver rejects pyserial
2026-10-27 logger: release DTR/RTS in the raw-port fallback so the board isn't held in reset
    [logger.py]
2026-10-27 logger --plan: fewer flicks per fault so the rest fits one lab slot
2026-10-27 Healthy + coin flicks
    [real_log.csv]
2026-10-27 Move rattling-coin flicks to data/real_old so the plan re-records the coin
    [real_log.csv]
2026-10-28 Fresh start: move Oct 27 flicks to data/real_old, re-record everything with the measured setup
    [real_log_oct27.csv]
2026-10-28 Real data: added mass, loose joint 1-2, loose support 1-3
    [real_log.csv]
2026-10-28 Retrain on real lab data: 4 classes, NN 94% (freq-only 84%)
    - Train on data/real (68 flicks); loose support 1/4 and 1/2 turn kept out
    (inside the healthy spread), checked as held-out flicks
    - support_damping plot, held-out check, rescore_log.py for the log
    - board/model.h + hex/TinySHM.hex rebuilt, PARITY OK
    - docs/REAL_RESULTS.md with tables, plots and board SysTick timings
    - real_log.csv cleaned of the bad-overlap rows
    [real_features.csv, real_log.csv]
2026-10-28 Report: clearer block diagram (100 MHz CPU vs 100 Hz sampling), fixed humanized Word file, first-person viva sheet
2026-10-28 Report: tighter photo pairs, straightened board photo, eq 3 fits, refreshed PDFs and Overleaf zip
2026-10-29 logger: --session lab menu (calibrate, weight, pick reading, live answer)
2026-10-29 logger: show each calibration flick and the baseline in the session menu
2026-10-29 Add clock check firmware (100 Hz tick counter on LCD) and TIMER1 vector
2026-10-29 Add LCD-only test firmware to isolate display from timer code
2026-10-29 Clock check: poll Timer1 instead of interrupt
2026-10-29 Add all lab readings with calibration
    [real_log.csv]
2026-10-29 Retrain on all lab readings: relabel test-named files, rebuild features and model
    [real_features.csv, real_log.csv]
2026-10-29 Calibrated baseline: normalize frequency and damping to the 10-flick healthy calibration; retrain on both lab days; firmware and logger use the same normalization
    [real_features.csv]
2026-10-29 Taught conditions (key A) lower the health score like labelled damage
    [classify.c]
2026-10-29 Keypad marks: B = loose now, D = normal now; health follows the mark
    [main.c]
2026-10-29 Loose mark caps health at 50% and still follows frequency; normal mark leaves frequency in charge
    [main.c]
2026-10-29 Fix build: keep the model's unsafe flag under the loose mark
    [main.c]
2026-10-29 Coin (added mass) now lowers health to about 50%
    [real_features.csv]
2026-10-29 Coin lowers health only slightly (about 85%)
    [real_features.csv]
2026-10-29 Viva sheet: demo changes after the report (calibration baseline, 2 features, coin 85, B/D keys)
2026-10-30 Dashboard redesign: gauge, model votes, baseline deltas, spectrum, history zones, event log
    [dashboard.py]
2026-10-30 Dashboard: neon HUD theme, animated radar gauge, glow traces
2026-10-30 Dashboard: show calibration progress and f1 during calibration
2026-10-30 Dashboard: live calibration values (f1, damping, running baseline) per flick
2026-10-30 Dashboard: calibration card with per-flick f1/damping and baseline
2026-10-30 Dashboard: accept upper-case class names from the board
2026-10-30 Report: both days (131 flicks), calibration-relative 2-feature model, 5-feature test, dashboard figure
2026-10-30 Retrain on 5 calibration-relative features (5-8-4 NN); report and author block updated
    [real_features.csv]
